LuisPonce15/banco-mano-robotica/hardware/a4988.md

# A4988

## Conexión

Ver [pinout.md](pinout.md#a4988). Resumen:

- **VMOT / GND** a +12 V y GND de potencia, con un electrolítico de **100 µF** lo más cerca posible del módulo.
- **VDD / GND** a 3,3 V y GND del ESP32.
- **MS1, MS2, MS3 a VDD** → 1/16 de paso (3200 pasos por vuelta).
- **RST y SLP puenteados y conectados a VDD.** Muchos módulos no traen la resistencia de pull-up de RST: si solo los puenteas, quedan flotando (se mide ~1 V) y el driver no hace nada.
- **EN a GPIO27**: LOW = motor con fuerza, HIGH = motor suelto. Es compartido por los dos drivers.

## Corriente (Vref)

Mide entre el tornillo del potenciómetro y GND, con el driver alimentado y sin motor:

**I = Vref / (8 × Rs)**

| Resistencias de sensado (junto al chip) | Rs | Vref para 1,0 A | Vref para 1,2 A |
|---|---|---|---|
| R100 | 0,100 Ω | 0,80 V | 0,96 V |
| R068 | 0,068 Ω | 0,54 V | 0,65 V |
| R050 | 0,050 Ω | 0,40 V | 0,48 V |

Este banco usa **R100 a ~0,8 V (≈ 1 A)**. El A4988 **no** reduce la corriente en reposo: el motor se calienta igual quieto que en marcha.

## Calor

Disipador pegado al chip y ventilador de 5 V encima. A ~1 A sin ventilación el A4988 se apaga por temperatura, y eso se ve como pasos perdidos o un motor que "tartamudea".

## Reglas

- Nunca conectes ni desconectes el motor con el driver energizado: se quema el driver.
- Si un motor gira al revés, invierte `DIR` en el código (`INVERT_A` / `INVERT_B`) en vez de cambiar cables.
- Revisa la serigrafía de tu módulo: hay clones con el orden de pines invertido.
