LuisPonce15/banco-mano-robotica/hardware/ina219.md

# INA219

## Dirección I²C

Cada módulo tiene dos puentes para soldar, **A0** y **A1**. Dos módulos en el mismo bus deben tener **direcciones distintas**. Si no, solo aparece uno en el escaneo (`i` en `banco_prueba`).

| A1 | A0 | Dirección |
|---|---|---|
| — | — | **0x40** |
| — | soldado | **0x41** |
| soldado | — | **0x44** |
| soldado | soldado | **0x45** |

Plan del banco: **INA1 (DS3240) = 0x40** sin puentes, **INA2 (DS3235) = 0x41** con A0 soldado.

Si tus dos módulos vienen con A1 soldado (los dos en 0x44), tienes dos opciones:

1. Suelda también A0 en uno de ellos → ese queda en **0x45**, el otro sigue en **0x44**.
2. Quita el puente A1 de uno → ese queda en **0x40**.

Luego cambia `INA1_ADDR` e `INA2_ADDR` en el código para que coincidan.

La pestaña **Depuración** de la página tiene una calculadora que detecta el conflicto.

## Rango

| Shunt | Rango | Resolución (CAL = 4096) | Caída a 3 A |
|---|---|---|---|
| R100 (0,1 Ω, de fábrica) | ±3,2 A | 0,1 mA | 0,30 V (el servo ve 5,7 V) |
| R050 (0,05 Ω) | ±6,4 A | 0,2 mA | 0,15 V |

El DS3240 en bloqueo puede pasar de 3,2 A. Con el shunt de fábrica la lectura se satura en ese punto.

## Alimentación

- VCC del módulo a **3,3 V** del ESP32 (así los niveles de I²C son de 3,3 V).
- Cada módulo trae pull-ups de 10 kΩ; con dos en paralelo quedan 5 kΩ, y eso está bien.
- Bus de 4 hilos trenzados (C62), de menos de 50 cm.

## Código de ejemplo (Fase 2)

```cpp
#include <Wire.h>
#include <Adafruit_INA219.h>
Adafruit_INA219 ina1(0x40), ina2(0x41);

void setup() {
  Wire.begin(21, 22);
  Wire.setClock(400000);
  ina1.begin(); ina2.begin();
  ina1.setCalibration_32V_2A();
  ina2.setCalibration_32V_2A();
}

void loop() {
  float i1 = ina1.getCurrent_mA() / 1000.0;   // A
  float v1 = ina1.getBusVoltage_V();          // voltaje en VIN− (lo que ve el servo)
  float i2 = ina2.getCurrent_mA() / 1000.0;
}
```
