LuisPonce15/banco-mano-robotica/fsr/hardware/cables.csv

id | desde | hasta | calibre | color | nota
P1 | Adaptador 12 V (+) | A4988 VMOT y C1 (+) | 20 AWG | rojo | directo al A4988: no pasa por el shield. C1 100 µF lo más cerca del módulo
P2 | Adaptador 12 V (−) | A4988 GND (potencia) y C1 (−) | 20 AWG | negro
L1 | Shield · fila 3V3 (izq. 1) | A4988 VDD | dupont H-H | violeta | 3V3 del regulador del ESP32: no depende del puente V del shield
L2 | Shield · fila GPIO25 · G | A4988 GND (lógica) | dupont H-H | negro | une la tierra del ESP32 con la de 12 V
L3 | A4988 VDD | MS1, MS2, MS3 | 24 AWG | violeta | 1/16 de paso (puentes en el lado del driver)
L4 | A4988 VDD | RST + SLP (puenteados) | 24 AWG | violeta | sin esto el driver queda dormido
S1 | Shield · fila GPIO25 · S (izq. 9) | A4988 STEP | dupont H-H | blanco
S2 | Shield · fila GPIO26 · S (izq. 10) | A4988 DIR | dupont H-H | blanco
S3 | Shield · fila GPIO27 · S (izq. 11) | A4988 EN | dupont H-H | blanco | LOW = motor con fuerza
M1 | A4988 1A / 1B | Motor verde / negro | original | verde / negro | bobina 1
M2 | A4988 2A / 2B | Motor azul / rojo | original | azul / rojo | bobina 2
H1 | Shield · fila GPIO16 · V (der. 12) | HX711-1 VCC (y VDD) | dupont H-H | violeta | el puente V del shield debe estar en 3V3
H2 | Shield · fila GPIO16 · G | HX711-1 GND | dupont H-H | negro
H3 | Shield · fila GPIO16 · S (der. 12) | HX711-1 DT | dupont H-H | amarillo
H4 | Shield · fila GPIO17 · S (der. 11) | HX711-1 SCK | dupont H-H | azul
H5 | Shield · fila GPIO18 · V (der. 9) | HX711-2 VCC (y VDD) | dupont H-H | violeta | el puente V del shield debe estar en 3V3
H6 | Shield · fila GPIO18 · G | HX711-2 GND | dupont H-H | negro
H7 | Shield · fila GPIO18 · S (der. 9) | HX711-2 DT | dupont H-H | amarillo
H8 | Shield · fila GPIO19 · S (der. 8) | HX711-2 SCK | dupont H-H | azul
C1 | Celda 1 (rojo / negro / blanco / verde) | HX711-1 E+ / E− / A− / A+ | original | 4 hilos | trenzar y alejar del motor
C2 | Celda 2 (rojo / negro / blanco / verde) | HX711-2 E+ / E− / A− / A+ | original | 4 hilos | trenzar y alejar del motor
F1 | Shield · fila GPIO34 · V (izq. 5) | FSR402 pata 1 | dupont H-H | rojo | el puente V del shield debe estar en 3V3: con 5 V se daña GPIO34
F2 | FSR402 pata 2 | Shield · fila GPIO34 · S (izq. 5) | dupont H-H | blanco | nodo del divisor
F3 | Shield · fila GPIO34 · S | Rm 10 kΩ → Shield · fila GPIO34 · G | — | — | resistencia del divisor entre S y G de la misma fila
F4 | Shield · fila GPIO34 · S | 100 nF → Shield · fila GPIO34 · G | — | — | opcional; en paralelo con Rm
U1 | USB del ESP32 | Computador | cable USB de datos | — | alimenta el ESP32 y lleva los datos. El conector DC del shield queda libre
