LuisPonce15/banco-mano-robotica/(commit log)

2026-10-29 Banco E-01: firmware, documentación de hardware y página interactiva
    - firmware/banco_prueba: prueba de hardware por Monitor Serie
    - firmware/banco_fase1: ejes por WiFi con homing
    - hardware/: BOM, pines, cableado, cables.csv, A4988, INA219, seguridad, bitácora de depuración
    - web/ + docs/: página con esquema, simulación, conexiones, código, puesta en marcha, depuración y consola USB
    - CI: compilación del firmware (esp32 2.x y 3.x) y verificación del sitio
    Claude-Session: https://claude.ai/code/session_014Wy76LfF66mEVHVNwaW7oD
    [cables.csv]
2026-10-29 CI: fase 1 solo con esp32 3.x; índice de código y Markdown mejorados
    - banco_fase1 necesita el paquete 3.x (sus librerías); banco_prueba se sigue probando con 2.0.17 y 3.x
    - Visor de código: ignora la página HTML incrustada en el .ino y reconoce firmas en varias líneas
    - Markdown: tablas y bloques sin recortar, enlaces automáticos, insignias de CI
    - actions/checkout v5, setup-python v6
    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
2026-10-29 Banco FSR: prensa para caracterizar un FSR402 en silicona
    - fsr/firmware/fsr_ensayo: ESP32 propio con A4988, 2x HX711 y divisor del FSR;
    tara, calibración guardada, búsqueda de contacto, ensayos de ciclos y escalones,
    límite de fuerza y flujo de datos D,... por USB
    - fsr/hardware: conexiones, montaje, calibración y lista de cables
    - fsr/analisis: registro por USB y análisis (ajustes, histéresis, repetibilidad)
    - docs/fsr: página con banco virtual, toma de datos por Web Serial, análisis,
    esquemático interactivo, elección de Rm, modelo y visor de código
    - web/comun/repo.js: visor de código y Markdown compartido
    - build_site.py genera las dos páginas en una sola pasada
    - CI c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
    [cables.csv]
2026-11-04 Banco FSR: ESP32-S de 38 pines sobre base shield
    - Conexiones: mapa de pines del ESP32-S de 38 pines y filas G · V · S del shield
    - Página: vista interactiva del shield con los pines usados y lista de chequeo para pinear
    - cables.csv y conexiones.md con la posición de cada cable en el shield
    - Puente V en 3V3 y conector DC del shield sin usar
    - Mismos GPIO: el firmware no cambia (solo comentarios)
    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
    [cables.csv]
2026-11-04 Banco FSR: elegir placa de 30 o 38 pines y montaje con o sin shield
    - Conexiones: selector de placa (DevKit V1 30 p / ESP32-S 38 p) y de montaje (shield / directo)
    con pineado, tabla de pines y lista de chequeo propias de cada combinación
    - A4988 de cerca: conexión completa del banco o mínima (como la guía de Last Minute Engineers)
    - conexiones.md: pines del DevKit V1 de 30 pines y la conexión mínima del A4988
    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
2026-11-04 fsr_ensayo: DT de los HX711 con pull-up para probar el motor sin las celdas
    Sin HX711 conectado, DT flotaba y se leían fuerzas falsas que frenaban el
    motor al bajar. Con INPUT_PULLUP queda en HIGH (no listo) y la fuerza en 0.
    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
2026-11-09 fsr_lectura: prueba de conexión del FSR402 con línea base y umbral de detección
    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
2026-11-09 fsr_ensayo: límite del FSR en mV (vl) para no pasar de 2500 mV
    - Los ciclos, los escalones y los movimientos a mano dejan de bajar al llegar al límite y descargan
    - Escalones de hasta 99 pasos; FSR leído cada 10 ms
    - Página: campo «Límite del FSR», línea del límite en la gráfica y el banco virtual con la misma lógica
    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
2026-11-09 hx711_prueba: diagnóstico de las dos celdas de carga
    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
2026-11-09 hx711_prueba: compatible con esp32 2.x (sin inicializadores en el struct)
    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
2026-11-09 fsr_ensayo: calibración de las dos celdas juntas (cs) para la plataforma en modo suma
    Escala k1 y k2 para que F1 + F2 = masa·g con la masa donde presiona el punzón,
    corrige el signo e informa el reparto entre celdas. También en el banco virtual y en la página.
    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
    [fsr_ensayo.ino]
2026-11-09 Página FSR: botones de mover en ±1, ±0,1 y ±0,05 mm
    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
2026-11-09 Página FSR: lista «Antes de tomar datos» con botones para cada comando
    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
2026-11-09 FSR: ensayo de contacto, retardo del FSR (h1→h2) y rigidez de la silicona en el análisis; retardo en el modelo virtual
    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
2026-11-09 Análisis FSR: PNG de cada gráfica con fondo blanco u oscuro, ZIP con todas, y umbral ΔV del FSR elegible para h2
    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
2026-11-09 Retardo del FSR: h2 se busca desde la base (no desde h1), base robusta con revisión por ciclo, lecturas nuevas del HX711, corrección del retraso del HX711, mediana de ciclos usados
    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
2026-11-09 Análisis FSR: detecta meseta de fuerza y movimiento perdido, piso del ADC; ensayo de contacto que empieza en el aire y para con vl 2000
    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
2026-11-09 Análisis FSR: retraso del HX711 200 ms (medido) y botón para estimarlo con el ensayo; base de celdas con vibración como aviso; energía solo si es medible
    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
2026-11-09 FSR: ensayo de contacto por escalones (motor quieto en cada punto) y su análisis h1/h2 sin el retraso del HX711; procedimiento con prueba del papel
    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
2026-11-09 FSR: medición guiada (montaje rígido con f 10 → C; cúpula por escalones → Δh al modelo), cúpula R 30 mm y punzón Ø30; la demo virtual se cancela al mandar comandos
    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
2026-11-09 FSR: medición guiada sin h (busca el contacto por pasos con el motor quieto), empieza siempre en el aire y vuelve a la altura de partida
    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
2026-11-09 Medición guiada: el toque necesita dos escalones seguidos subiendo y la base se actualiza (deriva y ruido de las celdas); registro de cada paso de la búsqueda
    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
2026-11-09 Análisis FSR: aviso cuando el archivo es de ciclos continuos y no de la medición guiada
    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
2026-11-09 Ensayo: la gráfica de salida del FSR se autoescala y ya no dibuja las líneas de límite y saturación
    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
2026-11-09 Análisis FSR: h1 y h2 por umbrales fijos (ΔF y V elegibles con tolerancia), base con el motor en marcha, opción de corregir el retraso; tabla en CSV
    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
2026-11-10 Revertir «h1 y h2 por umbrales fijos» (vuelve a la versión anterior de la página FSR)
    This reverts commit 42dd2cb.
    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
2026-11-10 Medición guiada: acercamiento rápido con h (hasta 40 mm) y luego toque fino con pasos; vuelve a la altura de partida; nota de MS1–MS3
    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
